alufers/xiaomi-airpurifier-custom-board/xiaomi-airpurifier-custom-board/xiaomi-airpurifier-custom-board.kicad_pcb

## KiCad design xiaomi-airpurifier-custom-board/xiaomi-airpurifier-custom-board.kicad_pcb (2026-04-24)

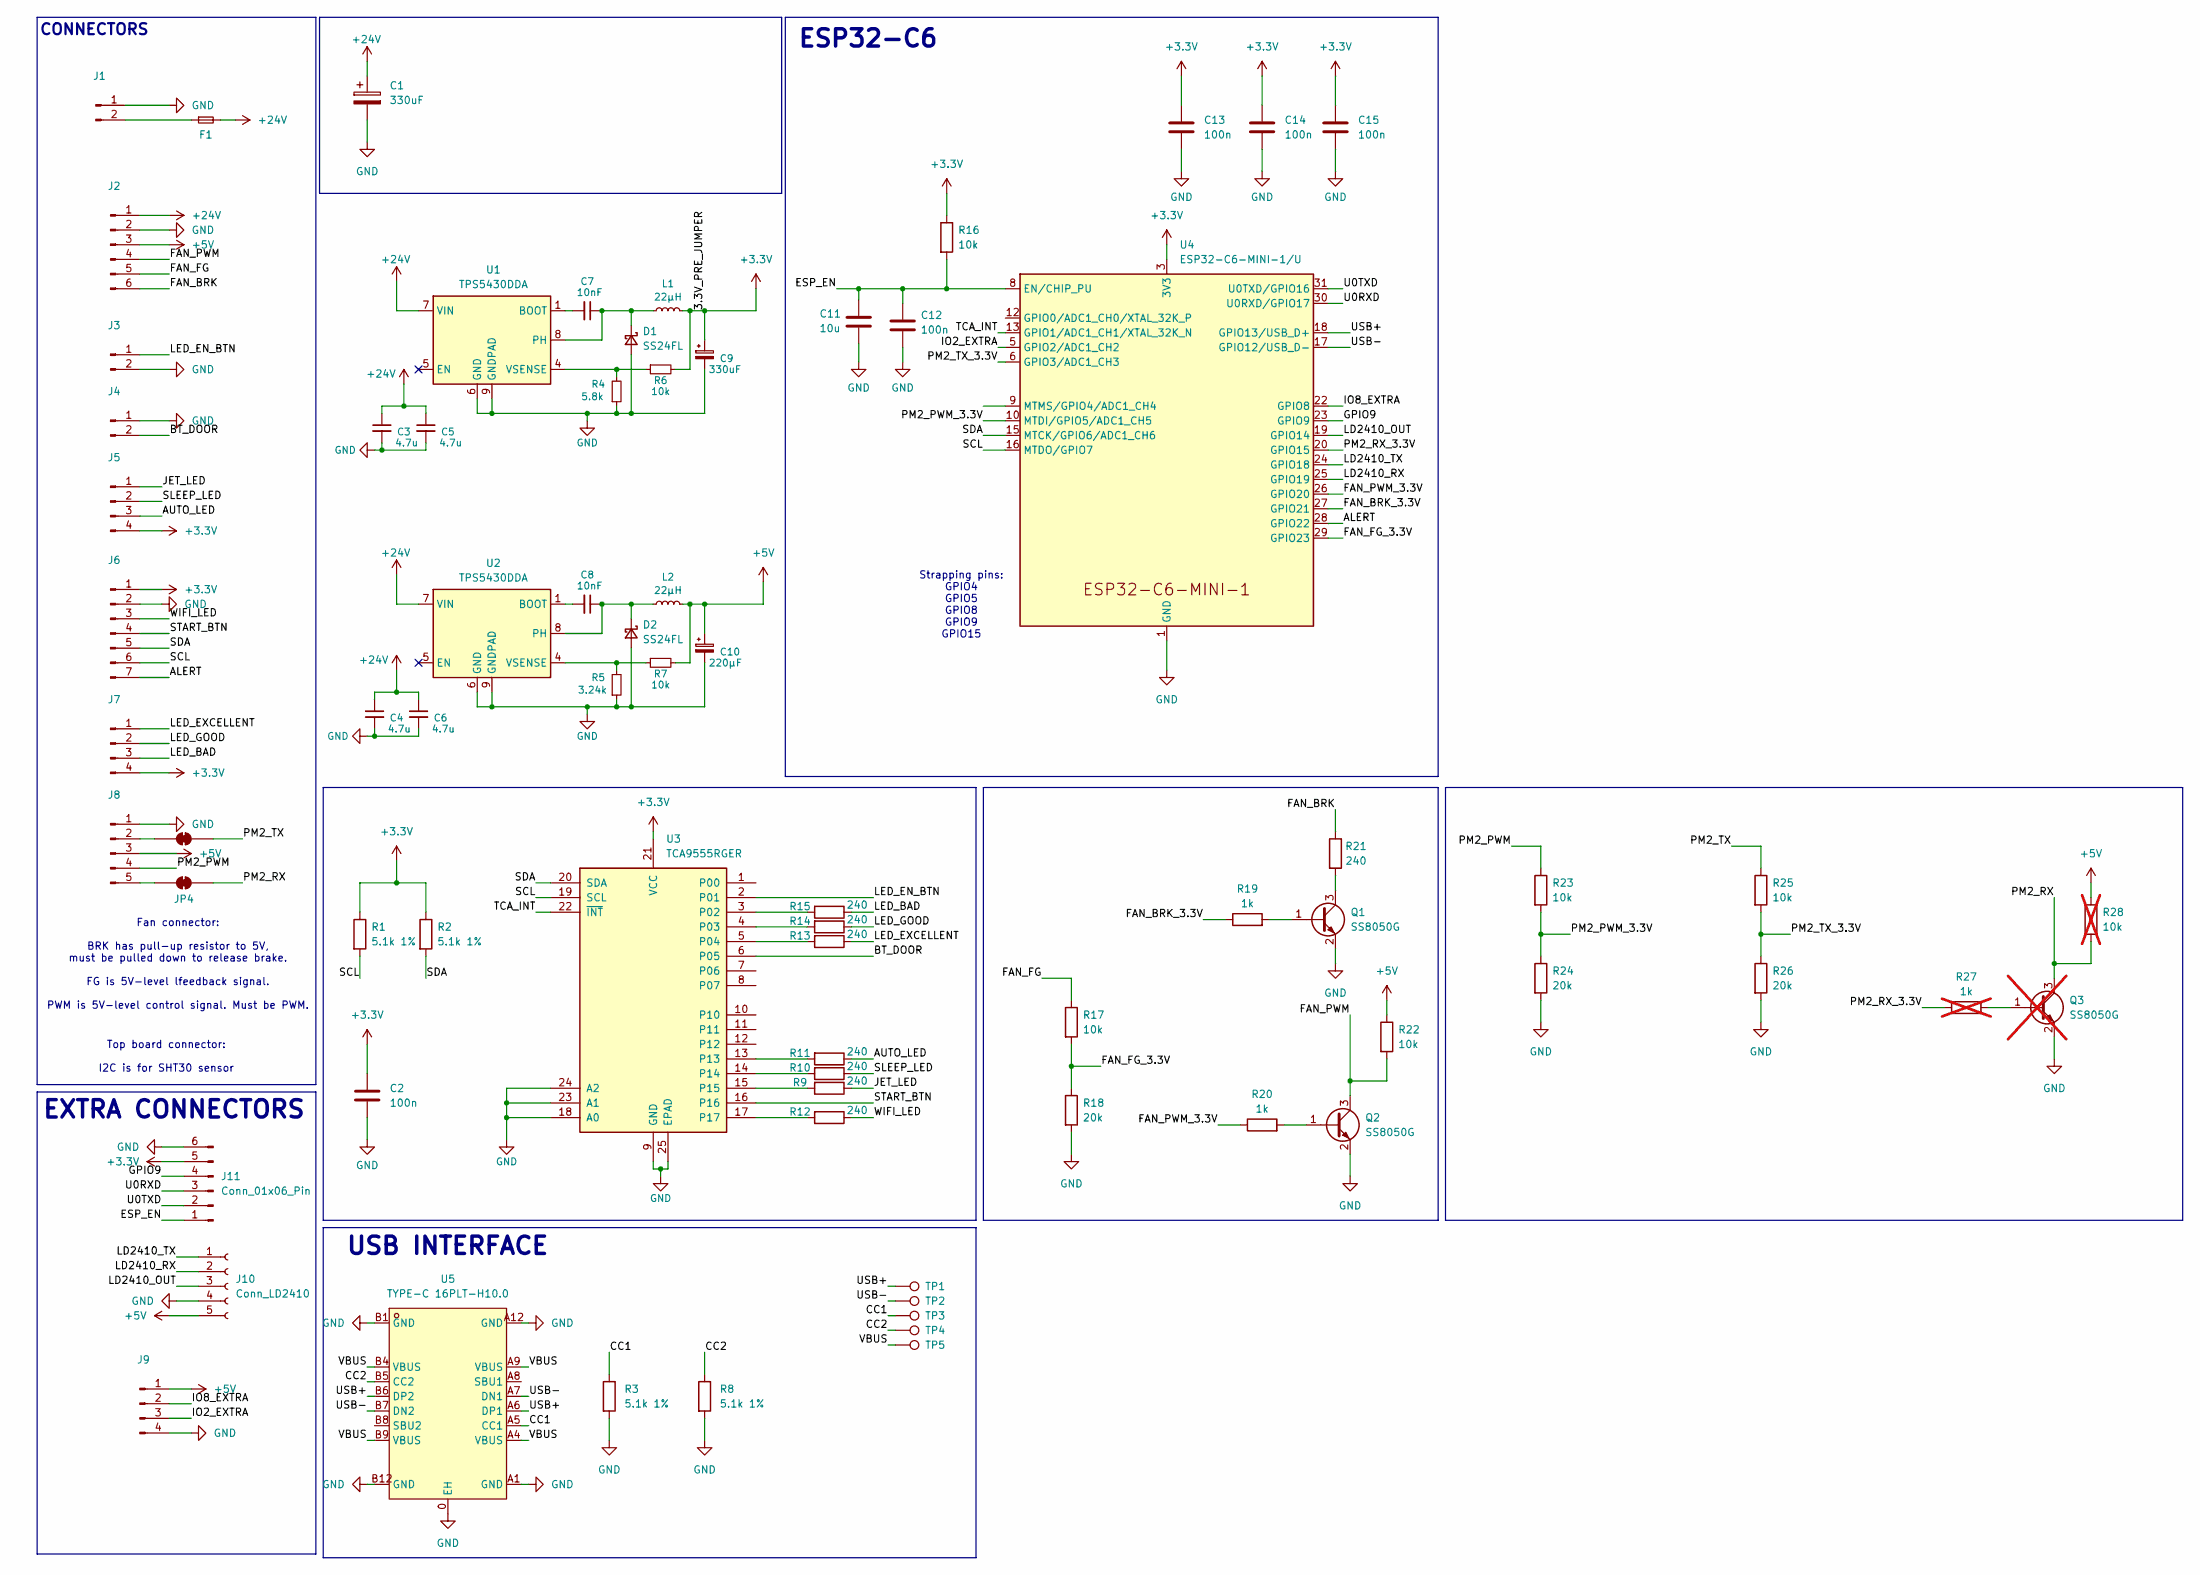
[picture p1: schematic xiaomi-airpurifier-custom-board.kicad_sch]

Parts:
C1: 330uF; CP_Elec_10x10.5; LCSC C88796
C2, C12, C13, C14, C15: 100n; C_0603_1608Metric; LCSC C14663
C3, C4, C5, C6: 4.7u; C_0805_2012Metric; LCSC C1779
C7, C8: 10nF; C_0805_2012Metric; LCSC C83170
C9: 330uF; CP_Elec_6.3x7.7; LCSC C47023104
C10: 220µF; CP_Elec_6.3x7.7; LCSC C72496
C11: 10u; C_0603_1608Metric; LCSC C96446
D1, D2: SS24FL; D_SOD-123F; LCSC C489144
F1: BSMD1812-300-24V; Fuse_1812_4532Metric_Pad1.30x3.40mm_HandSolder; LCSC C7500481
J1: XY-VH3.96-2A21; JST_VH_B2PS-VH_1x02_P3.96mm_Horizontal; LCSC C19271421
J2: JST S06B-PASK-2(LF)(SN); JST_PH_S6B-PH-K_1x06_P2.00mm_Horizontal; LCSC C495643
J3: B02B-PASK-1(LF)(SN); JST_PH_B2B-PH-K_1x02_P2.00mm_Vertical; LCSC C398555
J4: BX-PH2.0-2PZZ; JST_PH_B2B-PH-K_1x02_P2.00mm_Vertical; LCSC C18077744
J5: HDGC2001WV-4P; JST_PH_B4B-PH-K_1x04_P2.00mm_Vertical; LCSC C5175232
J6: B07B-PASK(LF)(SN); JST_PH_B7B-PH-K_1x07_P2.00mm_Vertical; LCSC C158042
J7: B04B-PASK-1(LF)(SN); JST_PH_B4B-PH-K_1x04_P2.00mm_Vertical; LCSC C160284
J8: B05B-PASK-1(LF)(SN); JST_PH_B5B-PH-K_1x05_P2.00mm_Vertical; LCSC C160282
J9: JST_PH_B4B-PH-K_1x04_P2.00mm_Vertical
J10: Conn_LD2410; PinSocket_1x05_P2.54mm_Vertical; LCSC C50950
J11: Conn_01x06_Pin; PinHeader_1x06_P2.54mm_Vertical; LCSC C37208
JP4, JP5: SolderJumper_2_Bridged; SolderJumper-2_P1.3mm_Bridged_RoundedPad1.0x1.5mm
L1, L2: 22µH; L_Sunlord_MWSA1003S; LCSC C475917
Q1, Q2: SS8050G; SOT-23; LCSC C164886
Q3: SS8050G; SOT-23; LCSC C164886; not fitted
R1, R2, R3, R8: 5.1k 1%; R_0603_1608Metric; LCSC C23186
R4: 5.8k; R_0603_1608Metric; LCSC C862231
R5: 3.24k; R_0603_1608Metric; LCSC C2933197
R6, R7, R16, R17, R22, R23, R25: 10k; R_0603_1608Metric; LCSC C25804
R9, R10, R11, R12, R13, R14, R15, R21: 240; R_0603_1608Metric_Pad0.98x0.95mm_HandSolder; LCSC C2907130
R18, R24, R26: 20k; R_0603_1608Metric; LCSC C105575
R19, R20: 1k; R_0603_1608Metric; LCSC C22548
R27: 1k; R_0603_1608Metric; LCSC C22548; not fitted
R28: 10k; R_0603_1608Metric; LCSC C25804; not fitted
TP1, TP2, TP3, TP4, TP5: TestPoint; TestPoint_Pad_D1.0mm
U1, U2: TPS5430DDA; TI_SO-PowerPAD-8_ThermalVias; LCSC C9864
U3: TCA9555RGER; VQFN-24-1EP_4x4mm_P0.5mm_EP2.45x2.45mm; LCSC C42420609
U4: ESP32-C6-MINI-1/U; ESP32-C6-MINI-1; LCSC C5736265
U5: TYPE-C 16PLT-H10.0; TYPE-C-SMD_USB4120-03-C; LCSC C3151749

Connections:
+3.3V: C2.1, C9.1, C13.1, C14.1, C15.1, J5.4, J6.1, J7.4, J11.5, L1.2, R1.1, R2.1, R6.2, R16.1, U3.21 (VCC), U4.3 (3V3)
+5V: C10.1, J2.3, J8.3, J9.1, J10.5, L2.2, R7.2, R22.1, R28.1
+24V: C1.1, C3.1, C4.1, C5.1, C6.1, F1.2, J2.1, U1.7 (VIN), U2.7 (VIN)
/ALERT: J6.7, U4.28 (GPIO22)
/AUTO_LED: J5.3, R11.1
/BT_DOOR: J4.2, U3.6 (P05)
/CC1: R3.1, TP3.1 (1_1), U5.A5 (CC1)
/CC2: R8.1, TP4.1 (1_1), U5.B5 (CC2)
/ESP_EN: C11.1, C12.1, J11.1, R16.2, U4.8 (EN/CHIP_PU)
/FAN_BRK: J2.6, R21.1
/FAN_BRK_3.3V: R19.1, U4.27 (GPIO21)
/FAN_FG: J2.5, R17.1
/FAN_FG_3.3V: R17.2, R18.1, U4.29 (GPIO23)
/FAN_PWM: J2.4, Q2.3 (C), R22.2
/FAN_PWM_3.3V: R20.1, U4.26 (GPIO20)
/GPIO9: J11.4, U4.23 (GPIO9)
/IO2_EXTRA: J9.3, U4.5 (GPIO2/ADC1_CH2)
/IO8_EXTRA: J9.2, U4.22 (GPIO8)
/JET_LED: J5.1, R9.1
/LD2410_OUT: J10.3, U4.19 (GPIO14)
/LD2410_RX: J10.2, U4.25 (GPIO19)
/LD2410_TX: J10.1, U4.24 (GPIO18)
/LED_BAD: J7.3, R15.1
/LED_EN_BTN: J3.1, U3.2 (P01)
/LED_EXCELLENT: J7.1, R13.1
/LED_GOOD: J7.2, R14.1
/PM2_PWM: J8.4, R23.1
/PM2_PWM_3.3V: R23.2, R24.1, U4.10 (MTDI/GPIO5/ADC1_CH5)
/PM2_RX: JP4.2 (B), Q3.3 (C), R28.2
/PM2_RX_3.3V: R27.1, U4.20 (GPIO15)
/PM2_TX: JP5.2 (B), R25.1
/PM2_TX_3.3V: R25.2, R26.1, U4.6 (GPIO3/ADC1_CH3)
/SCL: J6.6, R1.2, U3.19 (SCL), U4.16 (MTDO/GPIO7)
/SDA: J6.5, R2.2, U3.20 (SDA), U4.15 (MTCK/GPIO6/ADC1_CH6)
/SLEEP_LED: J5.2, R10.1
/START_BTN: J6.4, U3.16
/TCA_INT: U3.22 (~INT), U4.13 (GPIO1/ADC1_CH1/XTAL_32K_N)
/U0RXD: J11.3, U4.30 (U0RXD/GPIO17)
/U0TXD: J11.2, U4.31 (U0TXD/GPIO16)
/USB+: TP1.1 (1_1), U4.18 (GPIO13/USB_D+), U5.A6 (DP1), U5.B6 (DP2)
/USB-: TP2.1 (1_1), U4.17 (GPIO12/USB_D-), U5.A7 (DN1), U5.B7 (DN2)
/VBUS: TP5.1 (1_1), U5.A4 (VBUS), U5.A9 (VBUS), U5.B4 (VBUS), U5.B9 (VBUS)
/WIFI_LED: J6.3, R12.1
GND: C1.2, C2.2, C3.2, C4.2, C5.2, C6.2, C9.2, C10.2, C11.2, C12.2, C13.2, C14.2, C15.2, D1.2 (A), D2.2 (A), J1.1, J2.2, J3.2, J4.1, J6.2, J8.1, J9.4, J10.4, J11.6, Q1.2 (E), Q2.2 (E), Q3.2 (E), R3.2, R4.1, R5.1, R8.2, R18.2, R24.2, R26.2, U1.6 (GND), U1.9 (GNDPAD), U2.6 (GND), U2.9 (GNDPAD), U3.9 (GND), U3.18 (A0), U3.23 (A1), U3.24 (A2), U3.25 (EPAD), U4.1 (GND), U4.2 (GND), U4.11 (GND), U4.14 (GND), U4.36 (GND), U4.37 (GND), U4.38 (GND), U4.39 (GND), U4.40 (GND), U4.41 (GND), U4.42 (GND), U4.43 (GND), U4.44 (GND), U4.45 (GND), U4.46 (GND), U4.47 (GND), U4.48 (GND), U4.49 (GND), U4.50 (GND), U4.51 (GND), U4.52 (GND), U4.53 (GND), U5.0 (EH), U5.A1 (GND), U5.A12 (GND), U5.B1 (GND), U5.B12 (GND)
unnamed: C7.1, D1.1 (K), L1.1, U1.8 (PH)
unnamed: C8.1, D2.1 (K), L2.1, U2.8 (PH)
unnamed: F1.1, J1.2
unnamed: J8.2, JP5.1 (A)
unnamed: J8.5, JP4.1 (A)
unnamed: Q1.1 (B), R19.2
unnamed: Q1.3 (C), R21.2
unnamed: Q2.1 (B), R20.2
unnamed: Q3.1 (B), R27.2
unnamed: C7.2, U1.1 (BOOT)
unnamed: R4.2, R6.1, U1.4 (VSENSE)
unnamed: C8.2, U2.1 (BOOT)
unnamed: R5.2, R7.1, U2.4 (VSENSE)
unnamed: R15.2, U3.3 (P02)
unnamed: R14.2, U3.4 (P03)
unnamed: R13.2, U3.5 (P04)
unnamed: R11.2, U3.13
unnamed: R10.2, U3.14
unnamed: R9.2, U3.15
unnamed: R12.2, U3.17

Notes on the sheet:
EXTRA CONNECTORS
CONNECTORS
Strapping pins: GPIO4 GPIO5 GPIO8 GPIO9 GPIO15
Top board connector: I2C is for SHT30 sensor
ESP32-C6
USB INTERFACE
Fan connector: BRK has pull-up resistor to 5V, must be pulled down to release brake. FG is 5V-level lfeedback signal. PWM is 5V-level control signal. Must be PWM.

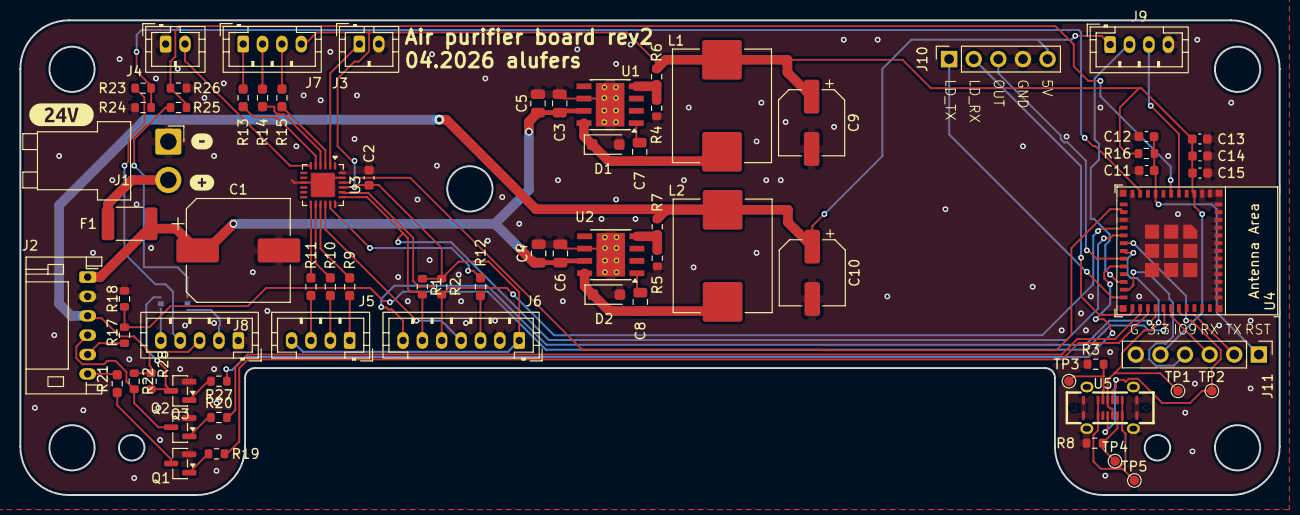
[picture p2: board xiaomi-airpurifier-custom-board.kicad_pcb from above]

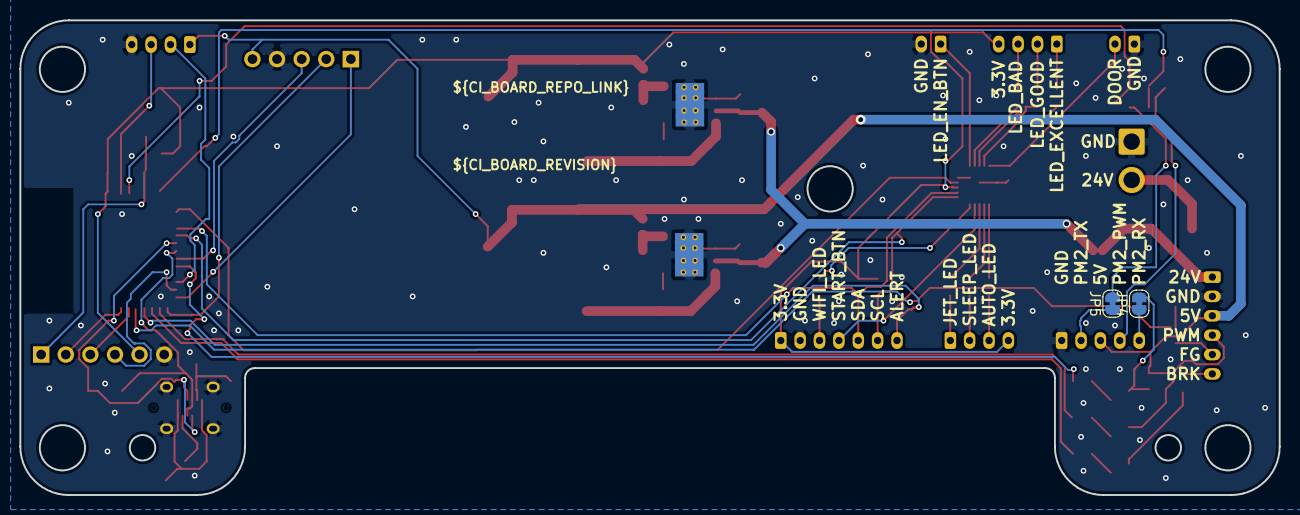
[picture p3: board xiaomi-airpurifier-custom-board.kicad_pcb from below]

Board: 2 copper layers, 130.0 x 49.0 mm, 77 parts (2 on the bottom side), 64 nets.

Other parts of the board:
kibuzzard-69EA0A86: G***; kibuzzard-69EA0A86
kibuzzard-69EA0AD8: G***; kibuzzard-69EA0AD8
kibuzzard-69EA09FB: G***; kibuzzard-69EA09FB
