alufers/xiaomi-airpurifier-custom-board/(commit log)

2026-04-23 Add CI
    [xiaomi-airpurifier-custom-board.kicad_pcb, xiaomi-airpurifier-custom-board.kicad_sch]
2026-04-23 change clearance violation to warning
    [xiaomi-airpurifier-custom-board.kicad_pcb]
2026-04-23 fix CI shit, generate ibom
    [mipurifier-esphome-config.yaml]
2026-04-23 ci: fix ibom pcbnew path discovery and widen search scope
2026-04-23 ci: install kicad with recommends for pcbnew scripting, add xvfb for ibom
2026-04-24 Add variable definition for QR code to see what happens
    [xiaomi-airpurifier-custom-board.kicad_pcb]
